Fabien-B/kicad_libs_GRZ/Readme.md

# Kicad libraries by GRZ

A collection of Kicad libraries made by a collegue of mine.

This repository will be dropped at some point.

How to use it :

`git submodule add https://github.com/Fabien-B/kicad_libs_GRZ`

`git submodule update --init --recursive`
