Fabien-B/kicad_libs_GRZ/Symbols/PartsCSV/Sleipnir_v002.ods

Id | Référence | Boîtier | Quantité | Désignation | Fournisseur et réf
1 | JP1 | SolderJumper_2P_TrianglePads_0603 | 1 | SolderJumper_2P
2 | Q1 | Crystal_8Z | 1 | 8Z_16MHz
3 | C15,C17,C8,C9,C12,C13,C19,C39,C4,C44 | C_0603 | 10 | 10µF
4 | C7 | C_0603 | 1 | 1µF/25V/X5R
5 | IC7 | STM32F777VI | 1 | STM32F777VI
6 | C40,C28,C41 | C_0402 | 3 | 4.7µF
7 | J13 | PicoBlade_53398-0571 | 1 | I2C-3V3
8 | C33,C34,C43,C38,C36,C35,C29,C27,C26,C25,C24,C22,C20,C16,C11,C5,C42,C31 | C_0402 | 18 | 100nF
9 | C32,C23,C21,C30 | C_0402 | 4 | 1µF
10 | IC6 | LIS3MDL | 1 | LIS3MDL
11 | J20 | PicoBlade_53398-0571 | 1 | UART7
12 | J16 | PicoBlade_53398-0571 | 1 | I2C-5V
13 | C1,C2 | C_0402 | 2 | 10pF
14 | J8 | USB_Micro-B_Molex_105017-0001 | 1 | USB_Micro-B
15 | J4 | PicoBlade_53398-0371 | 1 | SRVa2
16 | J18 | MicroSD_503182-1852 | 1 | MICRO-SD
17 | LED4 | KP-1608SYC | 1 | KP-1608SYC
18 | LED3 | KP-1608CGCK | 1 | KP-1608CGCK
19 | LED2 | KP-1608SEC | 1 | KP-1608SEC
20 | LED1 | KP-1608SURC | 1 | KP-1608SURC
21 | IC9 | BMP388 | 1 | BMP388
22 | IC8 | PCA9306DCU | 1 | PCA9306DCU
23 | J15 | PicoBlade_53398-0571 | 1 | RC
24 | J19 | PicoBlade_53398-0571 | 1 | UART3
25 | J17 | PicoBlade_53398-0571 | 1 | UART2
26 | J12 | PicoBlade_53398-0571 | 1 | SWD
27 | J9 | PicoBlade_53398-0571 | 1 | USB
28 | J14 | PicoBlade_53398-0771 | 1 | SPI
29 | J11 | PicoBlade_53398-0771 | 1 | AUXb
30 | J10 | PicoBlade_53398-0771 | 1 | AUXa
31 | J5 | PicoBlade_53398-0771 | 1 | SRVb
32 | J1 | PicoBlade_53398-0371 | 1 | SRVa1
33 | J7 | PicoBlade_53398-0371 | 1 | SRVa4
34 | J6 | PicoBlade_53398-0371 | 1 | SRVa3
35 | IC3 | TPS7A7200RGT | 1 | TPS7A7200RGT
36 | IC1,IC4 | LP5912DRV | 2 | LP5912-3.3DRV
37 | L1 | XFL4020 | 1 | 1µH
38 | IC2 | TPS621351 | 1 | TPS621351
39 | IC5 | ICM-20600 | 1 | ICM-20600
40 | C6 | EIA_3528-21 | 1 | 10µF/20V
41 | J3 | SquareWirePad_SMD_2x4mm | 1 | GND
42 | J2 | SquareWirePad_SMD_2x4mm | 1 | +BAT
43 | C37,C3,C10 | C_0402 | 3 | 10nF
44 | D2,D1 | PMEG3010AESB | 2 | PMEG3010AESB
45 | IC10 | TPS2001DDBV | 1 | TPS2001DDBV
46 | REF**,REF**,REF**,REF** | MountingHole_2.1mm_M2 | 4 | MountingHole_2.1mm_M2
47 | R19,R14,R13,R11,R10,R7,R6,R5,R4 | R_0402 | 9 | 2.2kΩ
48 | R18,R17,R16,R15 | R_0402 | 4 | 390Ω
49 | R12 | R_0402 | 1 | 220kΩ
50 | R8,R3 | R_0402 | 2 | 1.5kΩ
51 | R2,R1 | R_0402 | 2 | 12kΩ
52 | IC11 | MAX3051EKA | 1 | MAX3051EKA
53 | R9 | R_0402 | 1 | 120Ω
54 | R20 | R_0402 | 1 | 0Ω
55 | C14 | EIA_7360-38 | 1 | 1000µF/6.3V
56 | J21 | PicoBlade_53398-0271 | 1 | CAN
57 | REF**,REF**,REF**,REF** | SlottedMountingHoleM3_3.1x0.707 | 4 | SlottedMountingHoleM3_3.1x0.707
