Fabien-B/kicad_libs_GRZ/(commit log)

2019-10-31 Adds PMEG4050ETP diode.
2019-11-18 Adds 3D package for Resistor 0603.
2023-09-08 update libs*
    [74686.csv, STM32Nucleo-L476RG.csv, STM32Nucleo-L476RG.ods, uLCD-24PTU.csv, uLCD-24PTU.ods]
2023-10-13 Fix battery pinout (reversed polarity).
